ntate6630/Parallel_port/ParallelPort2.jpg

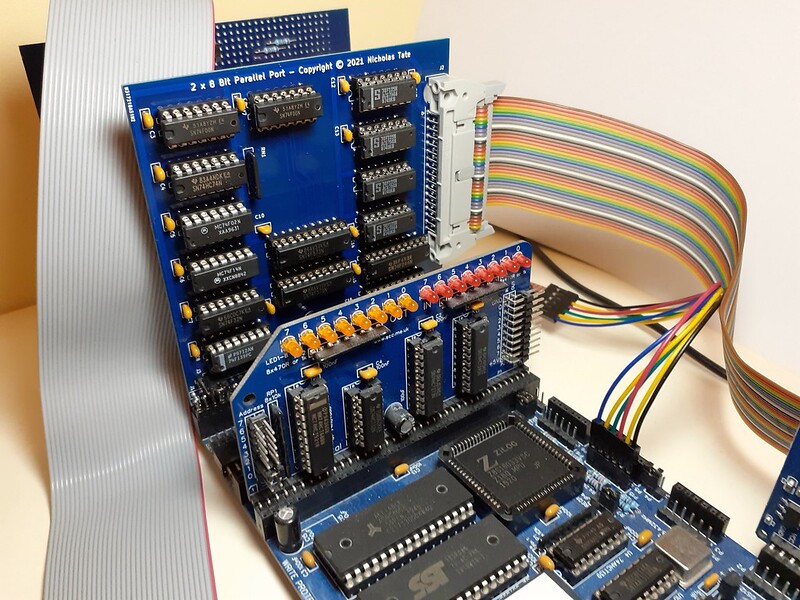
ParallelPort2.jpg
