ntate6630/Parallel_port/ParallelPort1.jpg

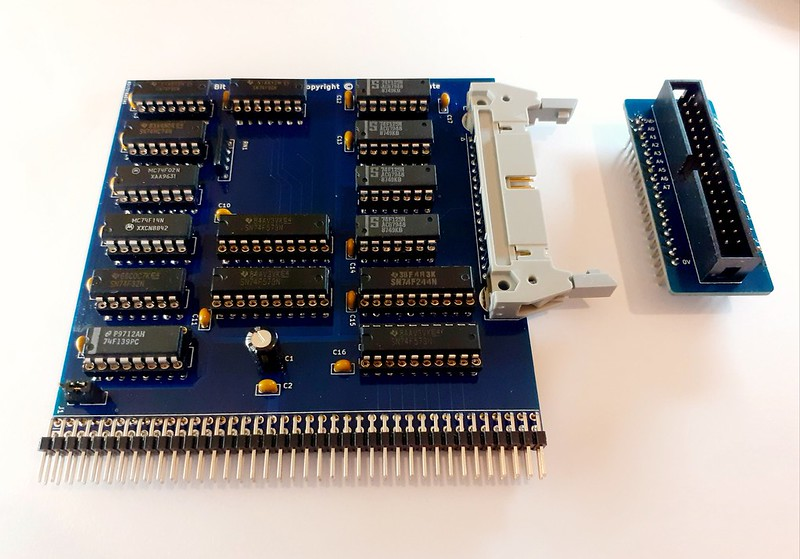
ParallelPort1.jpg
