ntate6630/Parallel_port/Parallel Port V7/Parallel_Port.pdf

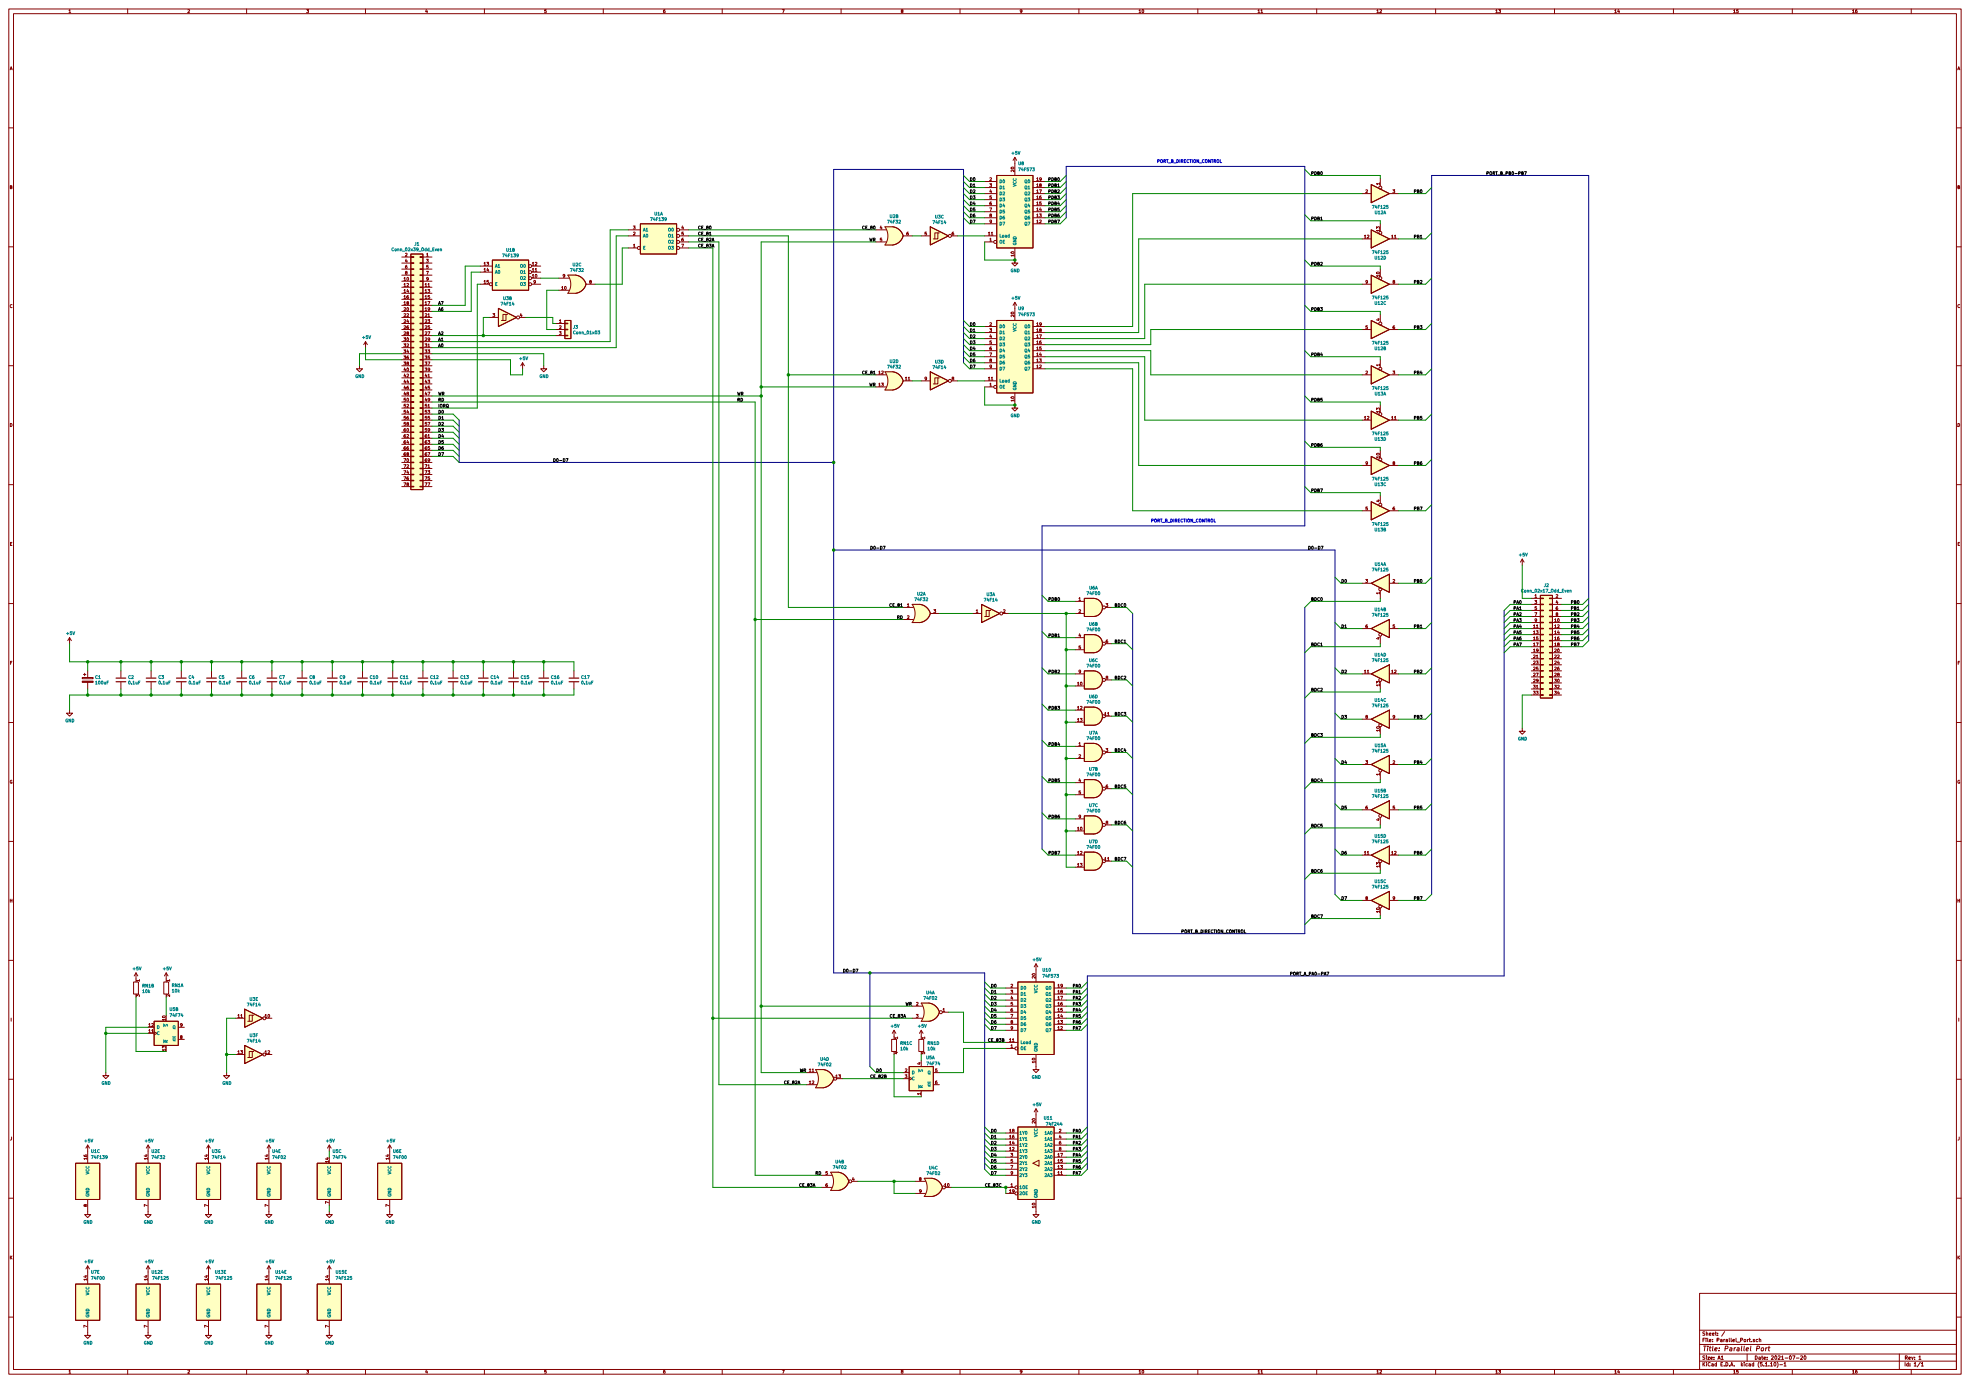
[picture p3: page 1]

File: Parallel_Port.sch Sheet: /
Id: 1/1 Title: Parallel Port
