ntate6630/Parallel_port/Parallel Port V7/Parallel_Port.kicad_pcb

## KiCad design Parallel Port V7/Parallel_Port.kicad_pcb (2022-03-21)

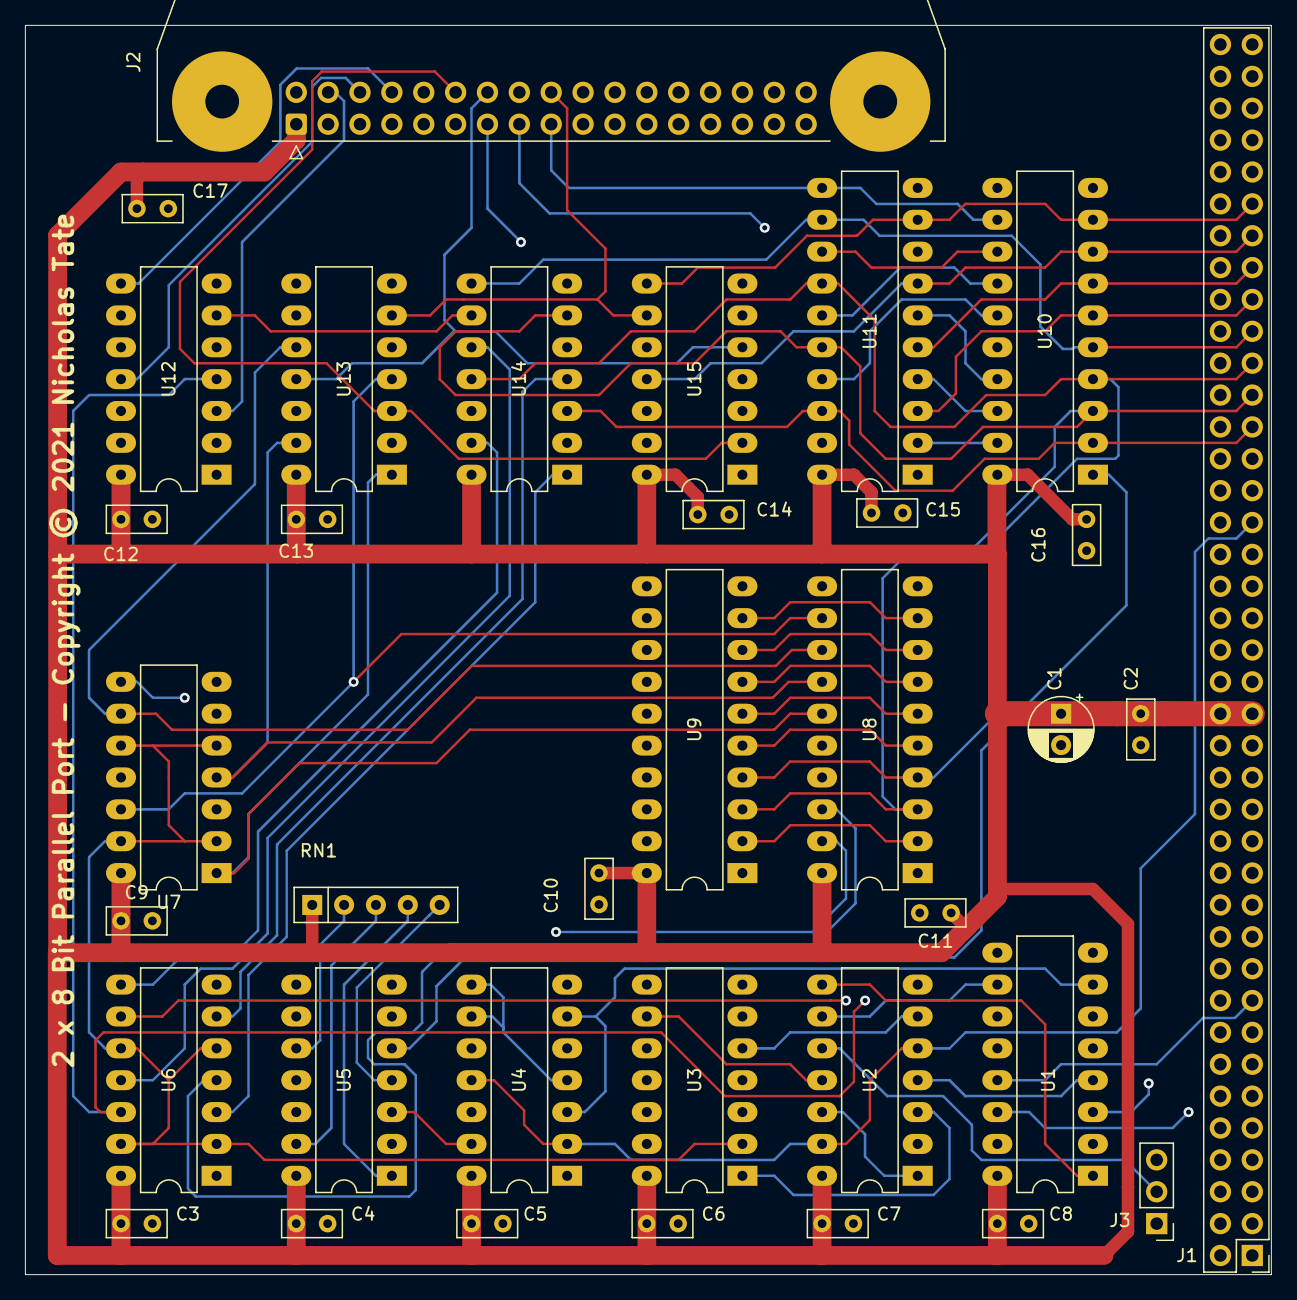
[picture p4: board Parallel_Port.kicad_pcb from above]

Board: 4 copper layers, 99.3 x 99.6 mm, 36 parts (0 on the bottom side), 81 nets.

Parts:
C1: 100uF; CP_Radial_D5.0mm_P2.50mm
C2, C3, C4, C5, C6, C7, C8, C9, C10, C11, C12, C13, C14, C15, C16, C17: 0.1uF; C_Rect_L4.6mm_W2.0mm_P2.50mm_MKS02_FKP02
J1: Conn_02x39_Odd_Even; PinHeader_2x39_P2.54mm_Vertical
J2: Conn_02x17_Odd_Even; IDC-Header_2x17-1MP_P2.54mm_Latch_Horizontal
J3: Conn_01x03; PinHeader_1x03_P2.54mm_Vertical
RN1: 10k; R_Array_SIP5
U1: 74F139; DIP-16_W7.62mm_LongPads
U2: 74F32; DIP-14_W7.62mm_LongPads
U3: 74F14; DIP-14_W7.62mm_LongPads
U4: 74F02; DIP-14_W7.62mm_LongPads
U5: 74F74; DIP-14_W7.62mm_LongPads
U6, U7: 74F00; DIP-14_W7.62mm_LongPads
U8, U9, U10: 74F573; DIP-20_W7.62mm_LongPads
U11: 74F244; DIP-20_W7.62mm_LongPads
U12, U13, U14, U15: 74F125; DIP-14_W7.62mm_LongPads

Connections:
+5V: C1.1, C2.1, C3.1, C4.1, C5.1, C6.1, C7.1, C8.1, C9.1, C10.1, C11.1, C12.1, C13.1, C14.1, C15.1, C16.1, C17.1, J1.35, J1.36, J2.1, RN1.1, U1.16, U2.14, U3.14, U4.14, U5.14, U6.14, U7.14, U8.20, U9.20, U10.20, U11.20, U12.14, U13.14, U14.14, U15.14
/A0: J1.31, U1.2
/A1: J1.29, U1.3
/A2: J1.27, J3.3, U3.3
/A6: J1.19, U1.14
/A7: J1.17, U1.13
/BDC0: U6.3, U14.1
/BDC1: U6.6, U14.4
/BDC2: U6.8, U14.13
/BDC3: U6.11, U14.10
/BDC4: U7.3, U15.1
/BDC5: U7.6, U15.4
/BDC6: U7.8, U15.13
/BDC7: U7.11, U15.10
/CE_80: U1.4, U2.4
/CE_81: U1.5, U2.1, U2.12
/CE_82A: U1.6, U4.12
/CE_82B: U4.13, U5.3
/CE_83A: U1.7, U4.3, U4.6
/CE_83B: U4.1, U10.11
/CE_83C: U4.10, U11.1, U11.19
/D0: J1.53, U5.2, U8.2, U9.2, U10.2, U11.18, U14.3
/D1: J1.55, U8.3, U9.3, U10.3, U11.16, U14.6
/D2: J1.57, U8.4, U9.4, U10.4, U11.14, U14.11
/D3: J1.59, U8.5, U9.5, U10.5, U11.12, U14.8
/D4: J1.61, U8.6, U9.6, U10.6, U11.3, U15.3
/D5: J1.63, U8.7, U9.7, U10.7, U11.5, U15.6
/D6: J1.65, U8.8, U9.8, U10.8, U11.7, U15.11
/D7: J1.67, U8.9, U9.9, U10.9, U11.9, U15.8
/IORQ: J1.51, U1.15
/PA0: J2.3, U10.19, U11.2
/PA1: J2.5, U10.18, U11.4
/PA2: J2.7, U10.17, U11.6
/PA3: J2.9, U10.16, U11.8
/PA4: J2.11, U10.15, U11.17
/PA5: J2.13, U10.14, U11.15
/PA6: J2.15, U10.13, U11.13
/PA7: J2.17, U10.12, U11.11
/PB0: J2.4, U12.3, U14.2
/PB1: J2.6, U12.11, U14.5
/PB2: J2.8, U12.8, U14.12
/PB3: J2.10, U12.6, U14.9
/PB4: J2.12, U13.3, U15.2
/PB5: J2.14, U13.11, U15.5
/PB6: J2.16, U13.8, U15.12
/PB7: J2.18, U13.6, U15.9
/PDB0: U6.1, U8.19, U12.1
/PDB1: U6.4, U8.18, U12.13
/PDB2: U6.9, U8.17, U12.10
/PDB3: U6.12, U8.16, U12.4
/PDB4: U7.1, U8.15, U13.1
/PDB5: U7.4, U8.14, U13.13
/PDB6: U7.9, U8.13, U13.10
/PDB7: U7.12, U8.12, U13.4
/RD: J1.49, U2.2, U4.5
/WR: J1.47, U2.5, U2.13, U4.2, U4.11
GND: C1.2, C2.2, C3.2, C4.2, C5.2, C6.2, C7.2, C8.2, C9.2, C10.2, C11.2, C12.2, C13.2, C14.2, C15.2, C16.2, C17.2, J1.33, J1.34, J2.33, U1.8, U2.7, U3.7, U3.11, U3.13, U4.7, U5.7, U5.11, U5.12, U6.7, U7.7, U8.1, U8.10, U9.1, U9.10, U10.10, U11.10, U12.7, U13.7, U14.7, U15.7
unnamed: J3.1, U3.4
unnamed: J3.2, U2.10
unnamed: RN1.2, U5.10
unnamed: RN1.3, U5.13
unnamed: RN1.4, U5.1
unnamed: RN1.5, U5.4
unnamed: U1.1, U2.8
unnamed: U1.10, U2.9
unnamed: U2.3, U3.1
unnamed: U2.6, U3.5
unnamed: U2.11, U3.9
unnamed: U3.2, U6.2, U6.5, U6.10, U6.13, U7.2, U7.5, U7.10, U7.13
unnamed: U3.6, U8.11
unnamed: U3.8, U9.11
unnamed: U4.4, U4.8, U4.9
unnamed: U5.5, U10.1
unnamed: U9.19, U12.2
unnamed: U9.16, U12.5
unnamed: U9.17, U12.9
unnamed: U9.18, U12.12
unnamed: U9.15, U13.2
unnamed: U9.12, U13.5
unnamed: U9.13, U13.9
unnamed: U9.14, U13.12
