ntate6630/Parallel_port/(notices)

Notices in the files:
Parallel Port V7/Parallel_Port.kicad_pcb:
2 x 8 Bit Parallel Port - Copyright © 2021 Nicholas Tate
